ae271/Buggy/docs/buggy_photo.png

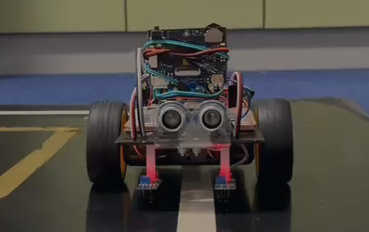
docs/buggy_photo.png
