ae271/Buggy/README.md

# Autonomous Line-Following Buggy – PID Speed Control

## Demo Video
Autonomous Buggy Demo (https://www.youtube.com/watch?v=HlLFTglX5Pk)

## Overview
This project is a team-based university engineering project involving the design and implementation of an autonomous buggy using an Arduino microcontroller.

The system implements closed-loop PID speed control, allowing the buggy to track a user-defined target velocity (e.g. 15 cm/s).

A Java-based desktop user interface communicates with the Arduino to set parameters and monitor behaviour.

---

## Repository Structure
- `firmware/` – Arduino firmware (C/C++)
- `ui/` – Java / Processing desktop UI
- `docs/` – Project report and diagrams

## Project Report
📄 [Project Report (PDF)](docs/Project%20Report.pdf)
